SuhasPatlolla/KiCad-Libraries/README.md

# KiCad-Libraries
This Repo has all the custom Libraries,symbols,footprints and 3d Models. This repo act as sub-module to any other KiCad Project repo so that we can import these libraries which makes a VCS or Centralized Sharing of Libraries
