SuhasPatlolla/KiCad-Libraries/Footprints/3D_Models/SS5P5-M3_87A.stp

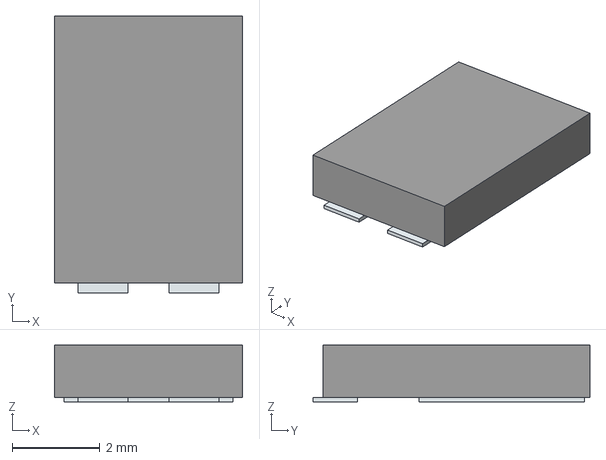
[picture p1: CAD file, 2025-12-13]
Footprints/3D_Models/SS5P5-M3_87A.stp
4.30 x 6.32 x 1.30 mm
Pins
