SuhasPatlolla/KiCad-Libraries/Footprints/ul_MP6531AGF-Z/ul_MP6531AGF-Z/MP6531AGF.stl

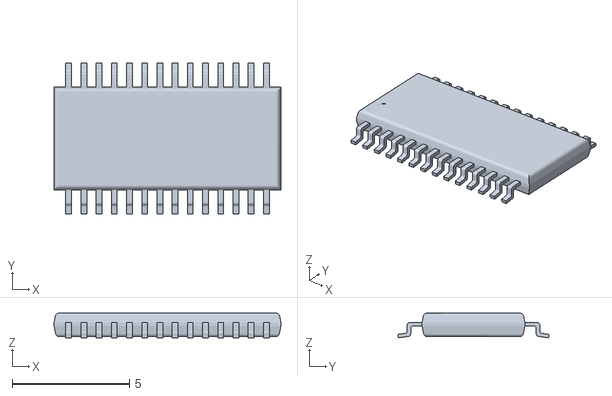
[picture p2: CAD file, 2025-12-11]
Footprints/ul_MP6531AGF-Z/ul_MP6531AGF-Z/MP6531AGF.stl
9.70 x 6.46 x 1.06
