SuhasPatlolla/KiCad-Libraries/Footprints/3D_Models/SBRT5A50SAF-13.stp

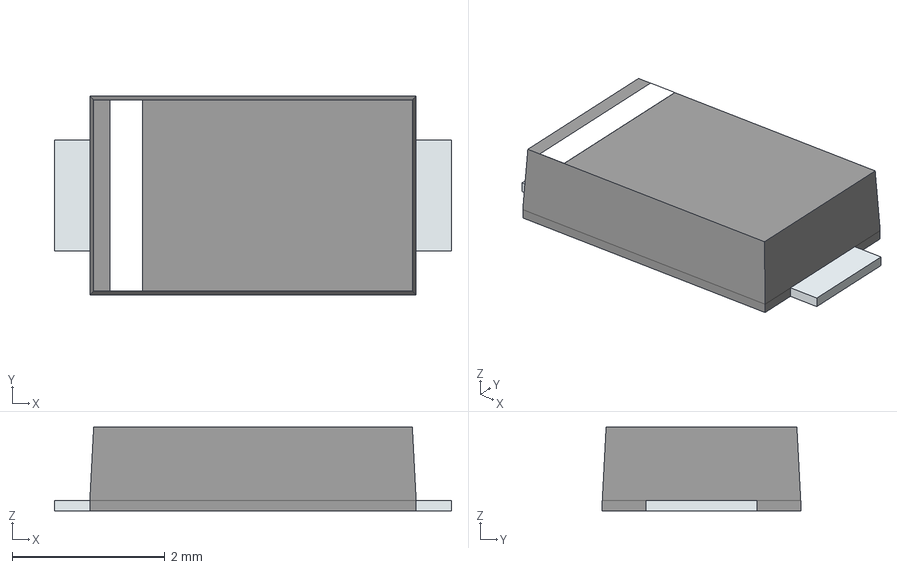
[picture p3: CAD file, 2025-12-13]
Footprints/3D_Models/SBRT5A50SAF-13.stp
5.20 x 2.60 x 1.10 mm
PinKIdent
PinK
PinA
