SuhasPatlolla/KiCad-Libraries/Footprints/3D_Models/PA4343.682ANLT.stp

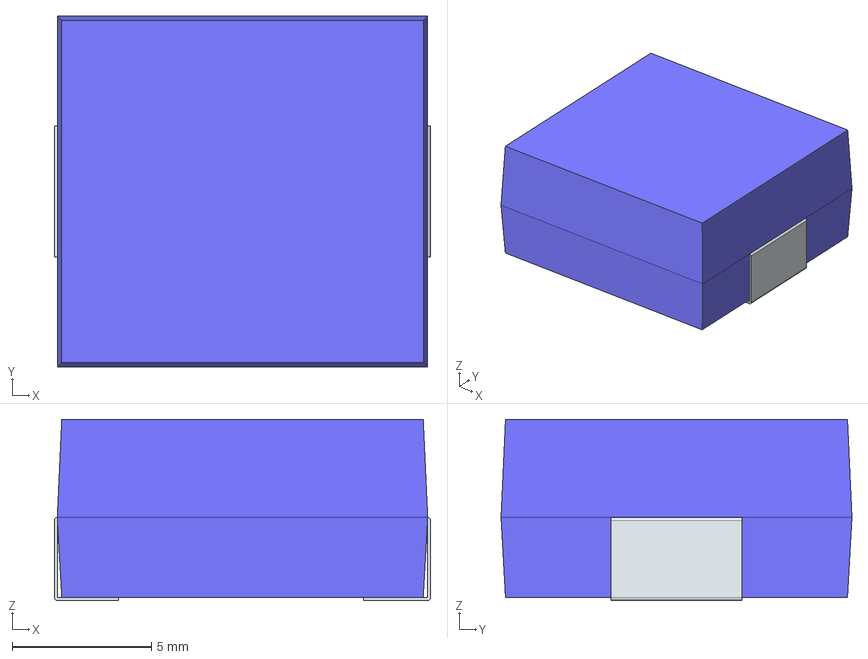
[picture p4: CAD file, 2025-12-13]
Footprints/3D_Models/PA4343.682ANLT.stp
13.5 x 12.6 x 6.50 mm
FilletPin1
FilletPin2
