SuhasPatlolla/KiCad-Libraries/Footprints/3D_Models/EDH476M063S9MAA.stp

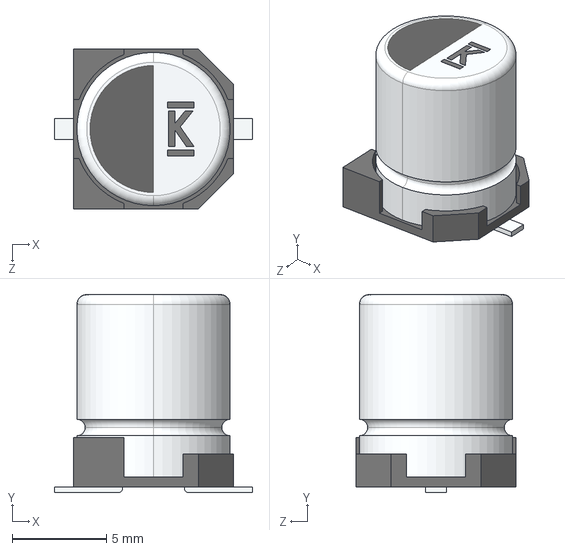
[picture p5: CAD file, 2025-12-13]
Footprints/3D_Models/EDH476M063S9MAA.stp
10.5 x 10.5 x 8.50 mm
