SuhasPatlolla/KiCad-Libraries/Footprints/3D_Models/RGY0024E.stp

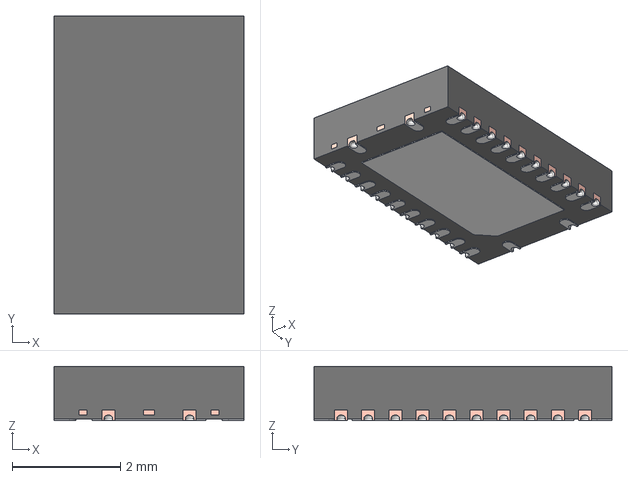
[picture p6: CAD file, 2025-12-13]
Footprints/3D_Models/RGY0024E.stp
3.50 x 5.50 x 1.00 mm
FRAME
