SuhasPatlolla/KiCad-Libraries/Footprints/3D_Models/CDZVT2R12B.stp

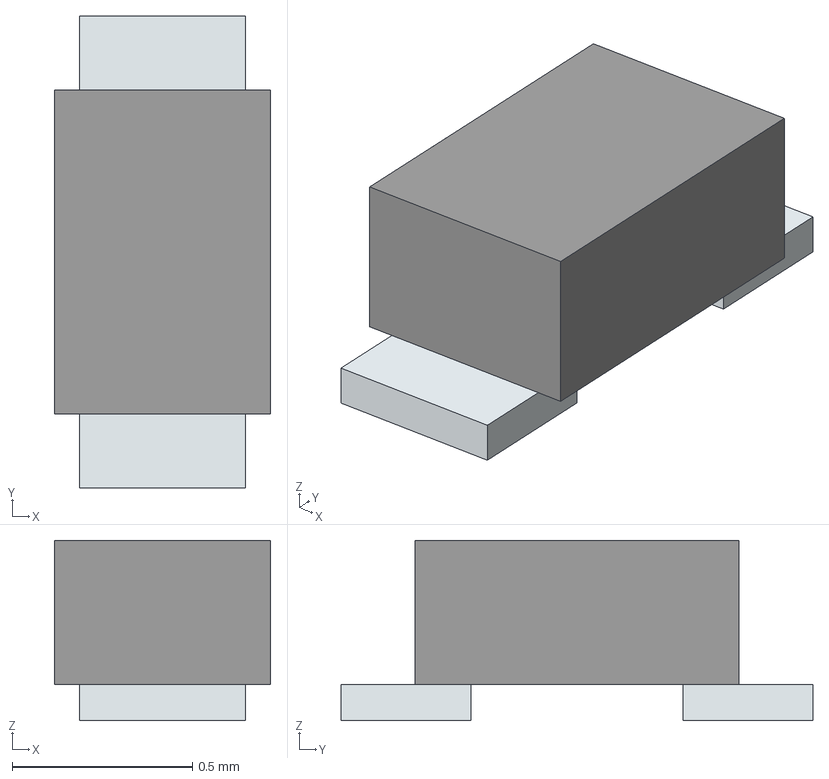
[picture p7: CAD file, 2025-12-11]
Footprints/3D_Models/CDZVT2R12B.stp
0.6 x 1.31 x 0.5 mm
Pins
