SuhasPatlolla/KiCad-Libraries/Footprints/3D_Models/RS6N120BHTB1.stp

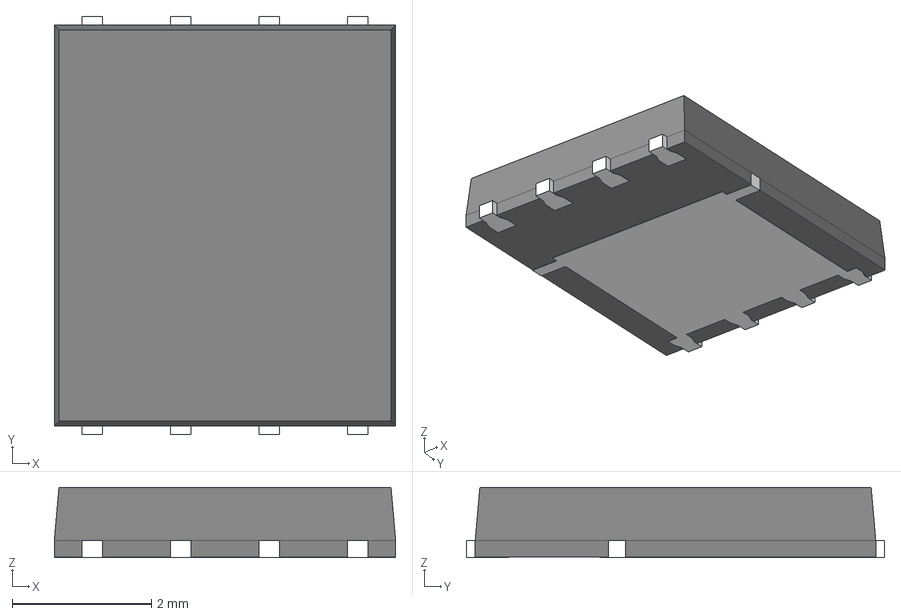
[picture p8: CAD file, 2025-12-11]
Footprints/3D_Models/RS6N120BHTB1.stp
4.90 x 6.00 x 1.01 mm
HSOP8_single_GEM-prt0
HSOP8_single_GEM-prt1
HSOP8_single_GEM-prt2
HSOP8_single_GEM-prt3
HSOP8_single_GEM-prt4
HSOP8_single_GEM-prt5
