SuhasPatlolla/KiCad-Libraries/Footprints/3D_Models/SOD323_DIO.step

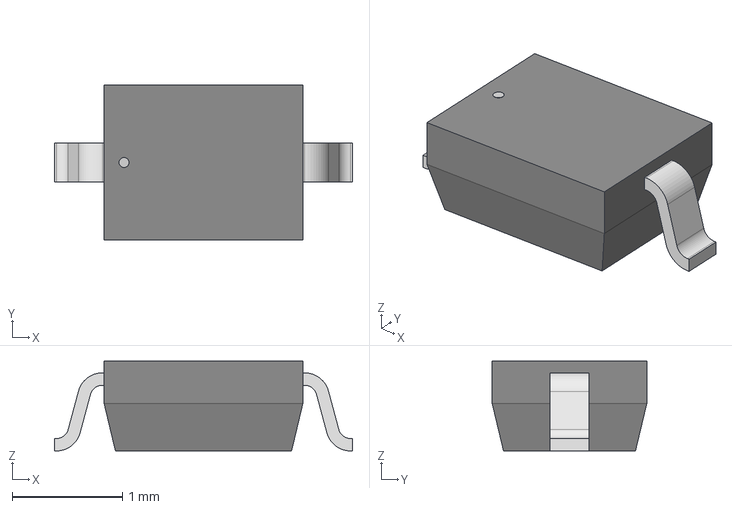
[picture p9: CAD file, 2025-12-11]
Footprints/3D_Models/SOD323_DIO.step
2.70 x 1.40 x 0.815 mm
