SuhasPatlolla/KiCad-Libraries/Footprints/3D_Models/MPX1D1250L330.stp

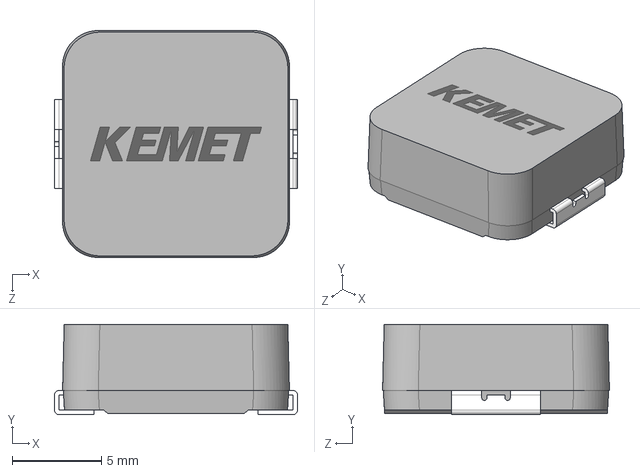
[picture p10: CAD file, 2025-12-11]
Footprints/3D_Models/MPX1D1250L330.stp
13.6 x 5.06 x 12.7 mm
