SuhasPatlolla/KiCad-Libraries/Footprints/3D_Models/PG-TDSO-16-30.stp

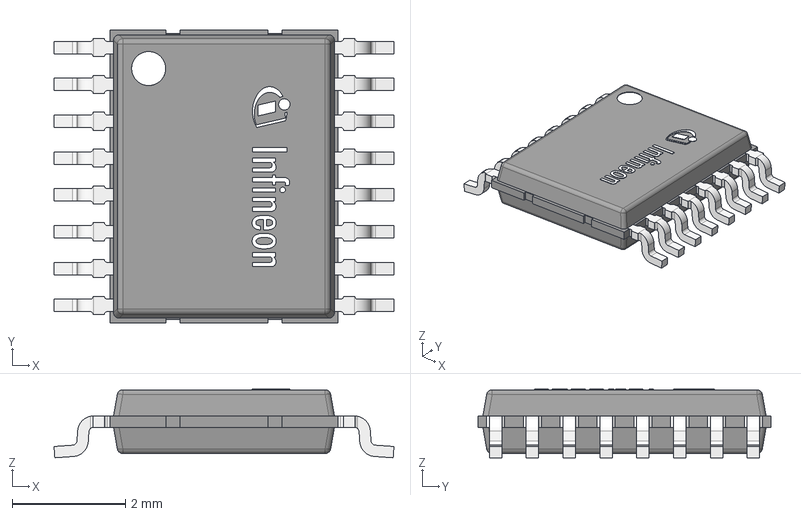
[picture p11: CAD file, 2025-12-11]
Footprints/3D_Models/PG-TDSO-16-30.stp
6.00 x 5.17 x 1.21 mm
