SuhasPatlolla/KiCad-Libraries/Footprints/3D_Models/MP6539BGV-P.stp

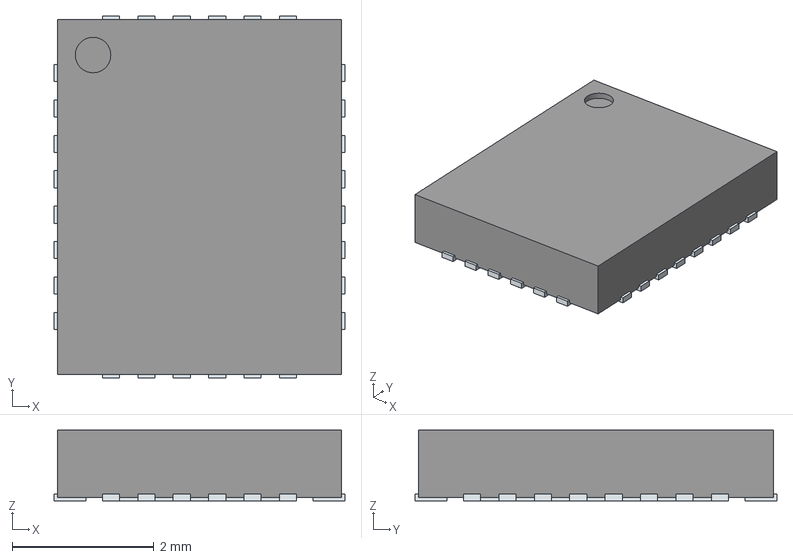
[picture p12: CAD file, 2025-12-11]
Footprints/3D_Models/MP6539BGV-P.stp
4.10 x 5.10 x 1.00 mm
ThermalPin
PinsArrayLR
PinsArrayTB
