SuhasPatlolla/KiCad-Libraries/Footprints/3D_Models/ADS1115BQDGSRQ1.stp

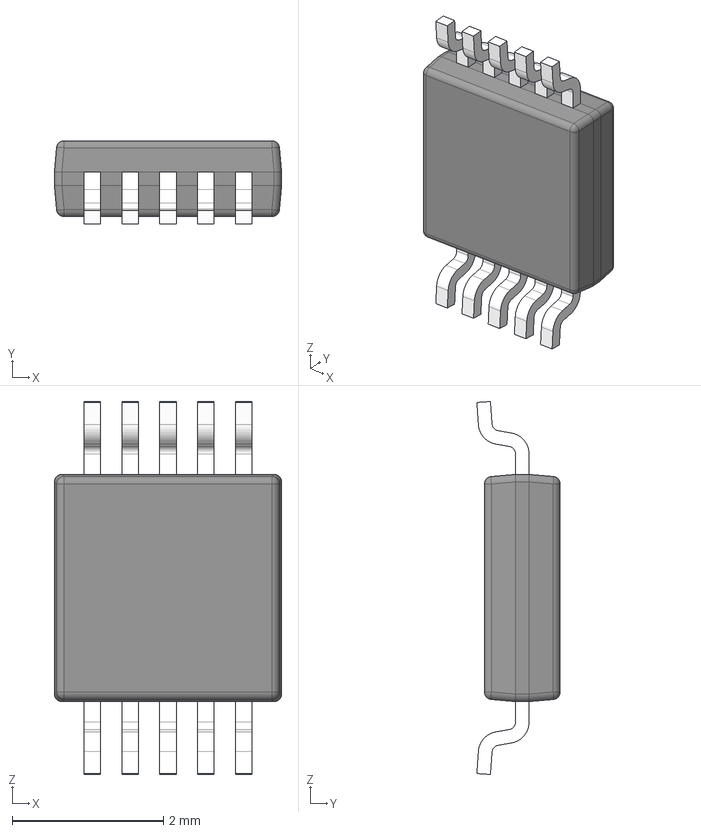
[picture p13: CAD file, 2025-12-11]
Footprints/3D_Models/ADS1115BQDGSRQ1.stp
3.00 x 1.10 x 4.93 mm
BODY-SO
LEAD-SO x 10
PIN1-ID
