SuhasPatlolla/KiCad-Libraries/Footprints/3D_Models/CDBC5150-HF.stp

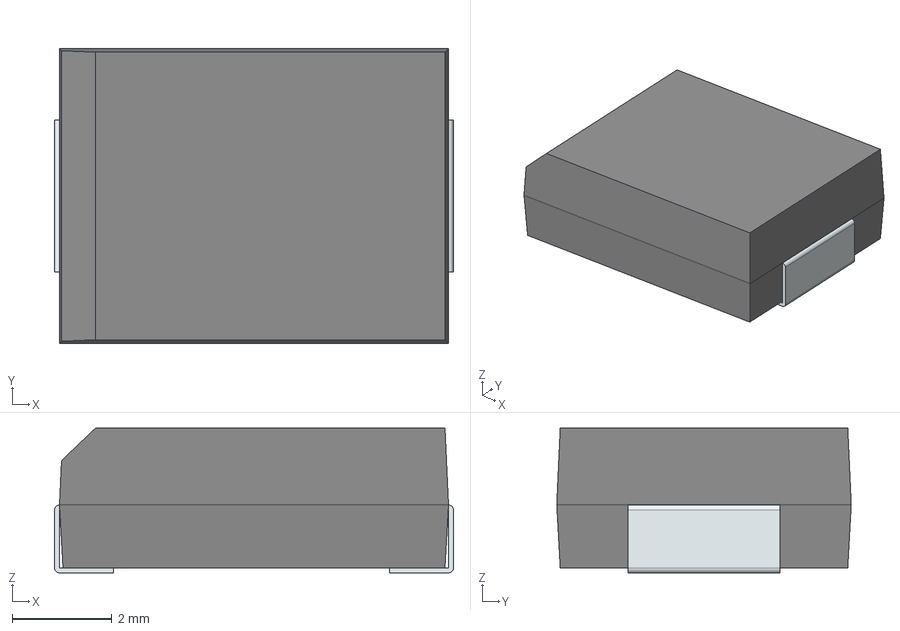
[picture p14: CAD file, 2025-12-11]
Footprints/3D_Models/CDBC5150-HF.stp
8.00 x 5.91 x 2.90 mm
FilletPin1
FilletPin2
