SuhasPatlolla/KiCad-Libraries/Footprints/3D_Models/XT60PW-M.step

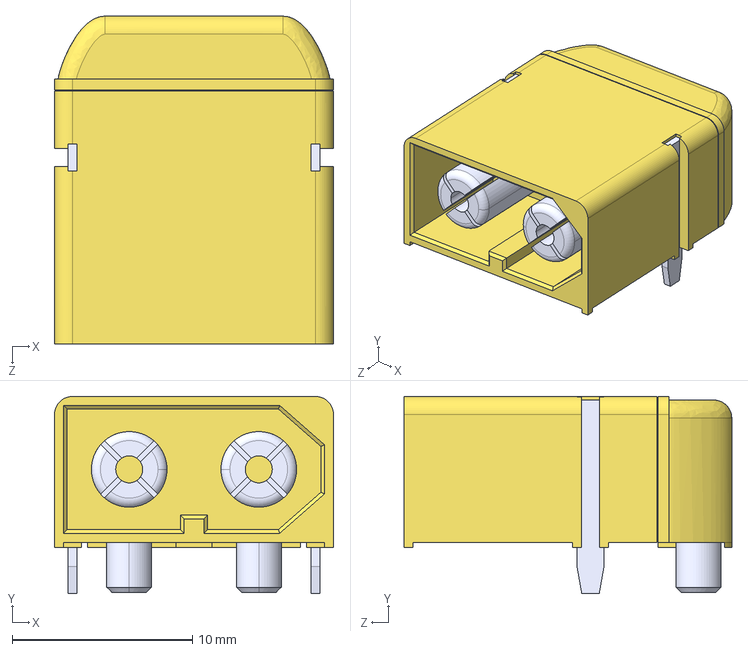
[picture p15: CAD file, 2025-12-11]
Footprints/3D_Models/XT60PW-M.step
15.5 x 10.9 x 18.2 mm
