SuhasPatlolla/KiCad-Libraries/Footprints/3D_Models/LD2981ABU33TR.stp

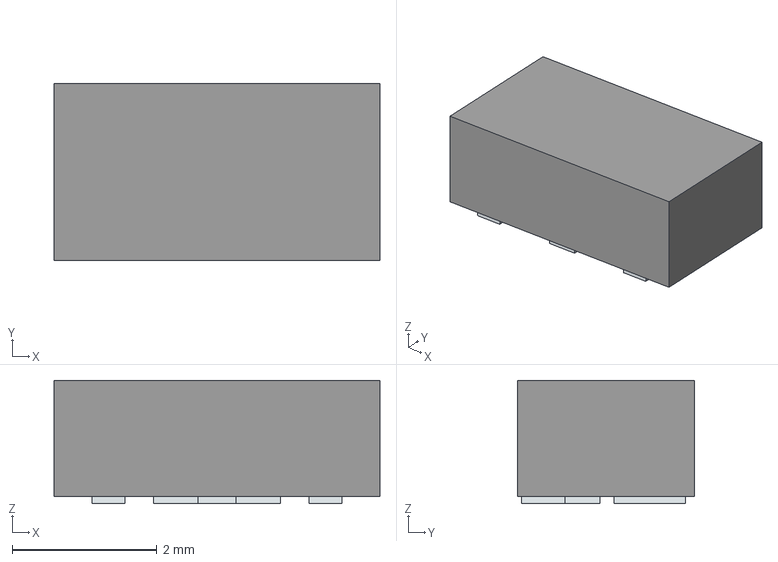
[picture p16: CAD file, 2025-12-11]
Footprints/3D_Models/LD2981ABU33TR.stp
4.50 x 2.45 x 1.70 mm
Pins
