SuhasPatlolla/KiCad-Libraries/Footprints/3D_Models/LM5013QDDARQ1.stp

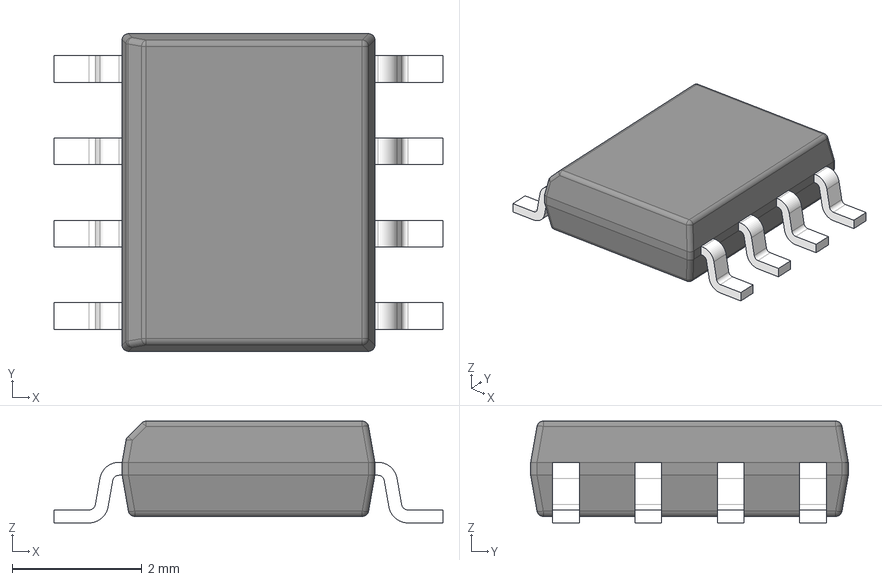
[picture p17: CAD file, 2025-12-11]
Footprints/3D_Models/LM5013QDDARQ1.stp
6.00 x 4.90 x 1.57 mm
BODY-SO
LEAD-SO x 8
THERMALPAD-SO
