SuhasPatlolla/KiCad-Libraries/Footprints/3D_Models/PG-TDSON-8-61_Z8B00221225_V01_3D.stp

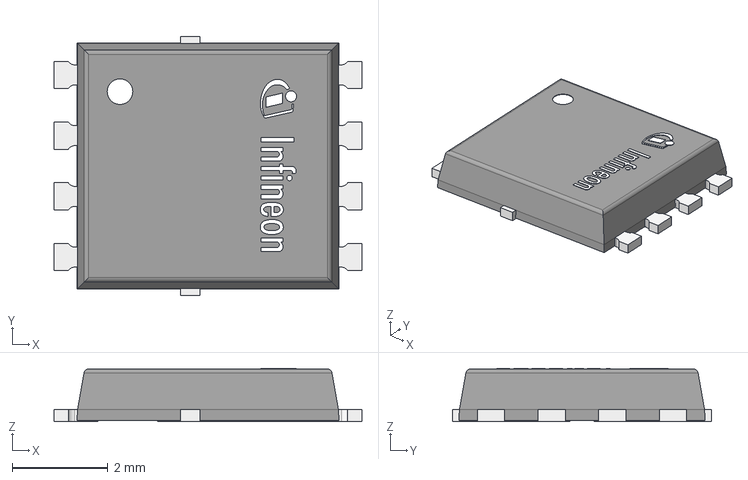
[picture p18: CAD file, 2025-12-11]
Footprints/3D_Models/PG-TDSON-8-61_Z8B00221225_V01_3D.stp
6.44 x 5.41 x 1.11 mm
