SuhasPatlolla/KiCad-Libraries/Footprints/3D_Models/MPX1D1250L150.stp

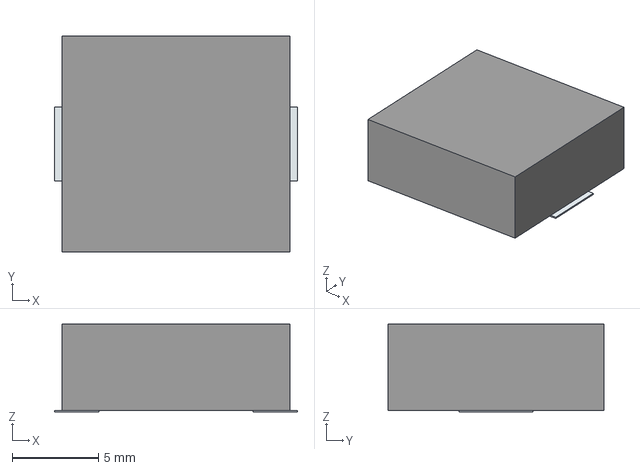
[picture p19: CAD file, 2025-12-11]
Footprints/3D_Models/MPX1D1250L150.stp
14.1 x 12.5 x 5.10 mm
Pins
