SuhasPatlolla/KiCad-Libraries/(list of files, cad)

Other CAD files:
Footprints/3D_Models/MP6531AGF.step
Footprints/3D_Models/502443-0270.stp
Footprints/LIB_502443-0270/502443-0270/Allegro/5024430270.psm
Footprints/LIB_502443-0270/502443-0270/DEHDL/502443_0270/chips/chips.prt
Footprints/LIB_ADS1115BQDGSRQ1/ADS1115BQDGSRQ1/Allegro/sop50p490x110-10n.psm
Footprints/LIB_ADS1115BQDGSRQ1/ADS1115BQDGSRQ1/DEHDL/ads1115bqdgsrq1/chips/chips.prt
Footprints/LIB_CDBC5150-HF/CDBC5150-HF/Allegro/diom8059x290n.psm
Footprints/LIB_CDBC5150-HF/CDBC5150-HF/DEHDL/cdbc5150_hf/chips/chips.prt
Footprints/LIB_CDZVT2R12B/CDZVT2R12B/Allegro/cdzvt2r20b.psm
Footprints/LIB_CDZVT2R12B/CDZVT2R12B/DEHDL/cdzvt2r12b/chips/chips.prt
Footprints/LIB_EDH476M063S9MAA/EDH476M063S9MAA/Allegro/capae830x1050n.psm
Footprints/LIB_EDH476M063S9MAA/EDH476M063S9MAA/DEHDL/edh476m063s9maa/chips/chips.prt
Footprints/LIB_LD2981ABU33TR/LD2981ABU33TR/DEHDL/ld2981abu33tr/chips/chips.prt
Footprints/LIB_LM5013QDDARQ1/LM5013QDDARQ1/Allegro/soic127p600x170-9n.psm
Footprints/LIB_LM5013QDDARQ1/LM5013QDDARQ1/DEHDL/lm5013qddarq1/chips/chips.prt
Footprints/LIB_MP6539BGV-P/MP6539BGV-P/Allegro/qfn50p400x500x100-29n.psm
Footprints/LIB_MP6539BGV-P/MP6539BGV-P/DEHDL/mp6539bgv_p/chips/chips.prt
Footprints/LIB_MPX1D1250L150/MPX1D1250L150/Allegro/indpm7065x300n.psm
Footprints/LIB_MPX1D1250L150/MPX1D1250L150/DEHDL/mpx1d1250l150/chips/chips.prt
Footprints/LIB_MPX1D1250L330/MPX1D1250L330/Allegro/indpm132125x500n.psm
Footprints/LIB_MPX1D1250L330/MPX1D1250L330/DEHDL/mpx1d1250l330/chips/chips.prt
Footprints/LIB_PA4343.682ANLT/PA4343.682ANLT/Allegro/indpm135126x650n.psm
Footprints/LIB_PA4343.682ANLT/PA4343.682ANLT/DEHDL/pa4343.682anlt/chips/chips.prt
Footprints/LIB_RS6N120BHTB1/RS6N120BHTB1/Allegro/rs6g120bgtb1.psm
Footprints/LIB_RS6N120BHTB1/RS6N120BHTB1/DEHDL/rs6n120bhtb1/chips/chips.prt
Footprints/LIB_SBRT5A50SAF-13/SBRT5A50SAF-13/Allegro/sodfl5226x110n.psm
Footprints/LIB_SBRT5A50SAF-13/SBRT5A50SAF-13/DEHDL/sbrt5a50saf_13/chips/chips.prt
Footprints/LIB_SS5P5-M3_87A/SS5P5-M3_87A/Allegro/ss3p6lm386a.psm
Footprints/LIB_SS5P5-M3_87A/SS5P5-M3_87A/DEHDL/ss5p5_m3_87a/chips/chips.prt
