SuhasPatlolla/KiCad-Libraries/(list of files, drawings)

Other design files:
Footprints/LIB_502443-0270/502443-0270/Altium/502443-0270.SchLib
Footprints/LIB_502443-0270/502443-0270/Altium/5024430270.PcbLib
Footprints/LIB_ADS1115BQDGSRQ1/ADS1115BQDGSRQ1/Altium/ADS1115BQDGSRQ1.SchLib
Footprints/LIB_ADS1115BQDGSRQ1/ADS1115BQDGSRQ1/Altium/SOP50P490X110-10N.PcbLib
Footprints/LIB_CDBC5150-HF/CDBC5150-HF/Altium/CDBC5150-HF.SchLib
Footprints/LIB_CDBC5150-HF/CDBC5150-HF/Altium/DIOM8059X290N.PcbLib
Footprints/LIB_EDH476M063S9MAA/EDH476M063S9MAA/Altium/CAPAE830X1050N.PcbLib
Footprints/LIB_EDH476M063S9MAA/EDH476M063S9MAA/Altium/EDH476M063S9MAA.SchLib
Footprints/LIB_LD2981ABU33TR/LD2981ABU33TR/Altium/LD2981ABU33TR.PcbLib
Footprints/LIB_LD2981ABU33TR/LD2981ABU33TR/Altium/LD2981ABU33TR.SchLib
Footprints/LIB_LM5013QDDARQ1/LM5013QDDARQ1/Altium/LM5013QDDARQ1.SchLib
Footprints/LIB_LM5013QDDARQ1/LM5013QDDARQ1/Altium/SOIC127P600X170-9N.PcbLib
Footprints/LIB_MP6539BGV-P/MP6539BGV-P/Altium/MP6539BGV-P.SchLib
Footprints/LIB_MP6539BGV-P/MP6539BGV-P/Altium/QFN50P400X500X100-29N.PcbLib
Footprints/LIB_MPX1D1250L150/MPX1D1250L150/Altium/MPX1D1250L150.PcbLib
Footprints/LIB_MPX1D1250L150/MPX1D1250L150/Altium/MPX1D1250L150.SchLib
Footprints/LIB_MPX1D1250L330/MPX1D1250L330/Altium/INDPM132125X500N.PcbLib
Footprints/LIB_MPX1D1250L330/MPX1D1250L330/Altium/MPX1D1250L330.SchLib
Footprints/LIB_PA4343.682ANLT/PA4343.682ANLT/Altium/INDPM135126X650N.PcbLib
Footprints/LIB_PA4343.682ANLT/PA4343.682ANLT/Altium/PA4343.682ANLT.SchLib
Footprints/LIB_SBRT5A50SAF-13/SBRT5A50SAF-13/Altium/SBRT5A50SAF-13.SchLib
Footprints/LIB_SBRT5A50SAF-13/SBRT5A50SAF-13/Altium/SODFL5226X110N.PcbLib
