SuhasPatlolla/KiCad-Libraries/(commit log)

2025-12-11 Libraries & Footprints
    [502443-0270.SchLib, 502443-0270.stp, 5024430270.PcbLib, 5024430270.psm, ADS1115BQDGSRQ1.SchLib, ADS1115BQDGSRQ1.stp, CDBC5150-HF.SchLib, CDBC5150-HF.stp]
2025-12-13 Added new Libraries
    [CAPAE830X1050N.PcbLib, EDH476M063S9MAA.SchLib, EDH476M063S9MAA.stp, EDI2CAP.CFG, INDPM135126X650N.PcbLib, PA4343.682ANLT.SchLib, PA4343.682ANLT.stp, RGY0024E.stp]
2025-12-19 added 3d folder
    [502443-0270.stp, ADS1115BQDGSRQ1.stp, CDBC5150-HF.stp, CDZVT2R12B.stp, EDH476M063S9MAA.stp, LD2981ABU33TR.stp, LM5013QDDARQ1.stp, MP6531AGF.step]
